lokichubs/TerraProbe/Documentation/CDR/FBD_Shaft_Design.pptx

y

z

x

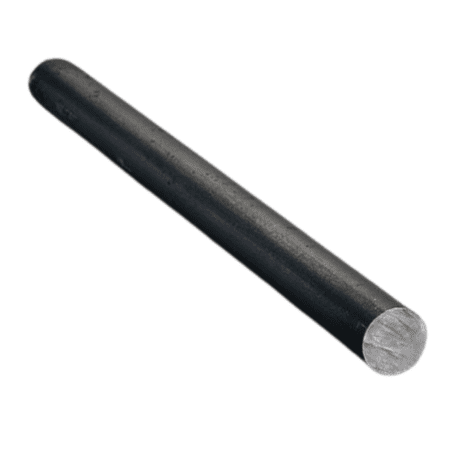
[picture p1: figure]
Plain Steel Shaft, 1 1/4 in x 3 ft - MDS

R_y

W_t

B_y

R_z

x = 0.375”

W_(tz)

B_z

x = 2.75”

3”
