lokichubs/TerraProbe/Documentation/CDR/Dashboard_Design.pptx

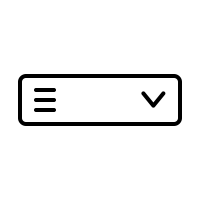
[picture p79: figure]
Dropdown Menu Icons - Free SVG & PNG Dropdown Menu Images - Noun Project

A Down2Earth (D2E)
Company

Soil-IQ Analytics Platform

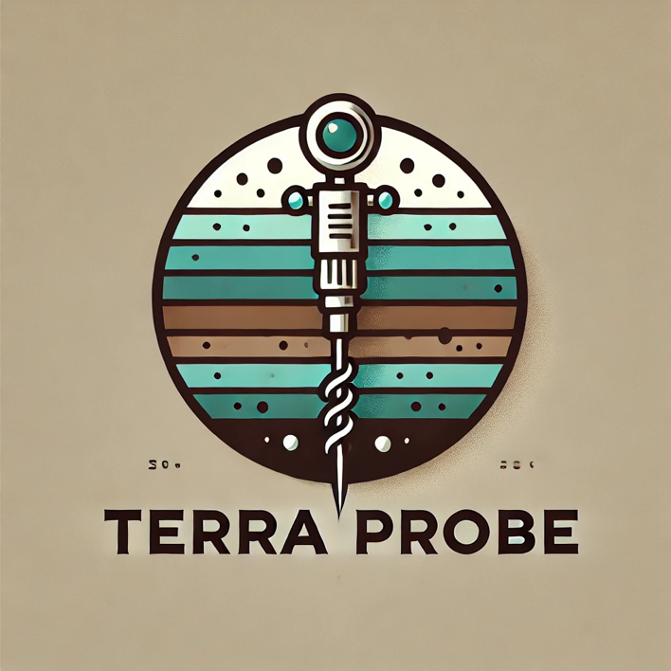
[picture p80: figure]

Soil Depth Properties at Depth of 2 inches

Read & Update Data

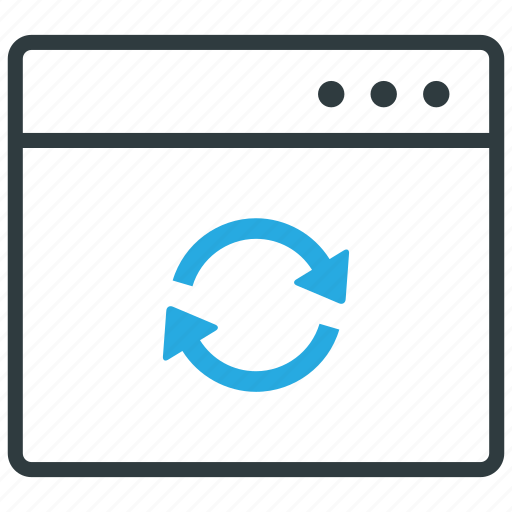
[picture p81: figure]
Browser, update, website, sync icon - Download on Iconfinder

Clear Data

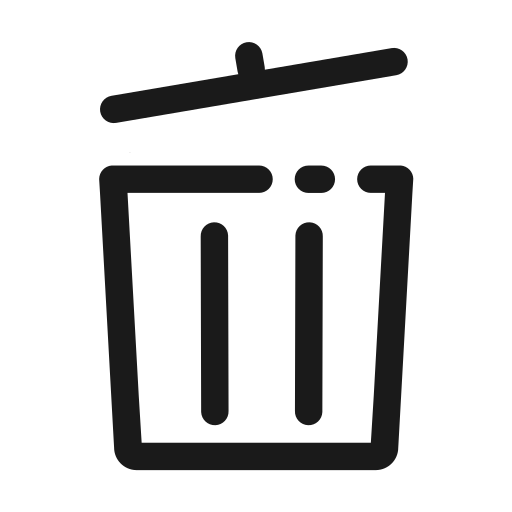
[picture p82: figure]
delete Vector Icons free download in SVG, PNG Format

Select Depth Measurements

2”

0.2

Moisture

50
mg/kg

Nitrogen

115
mg/kg

Potassium

123
mg/kg

Phosphorous

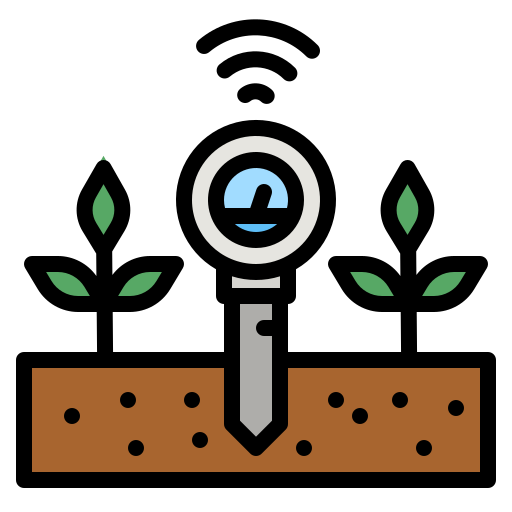
[picture p83: figure]
Soil analysis - Free farming and gardening icons
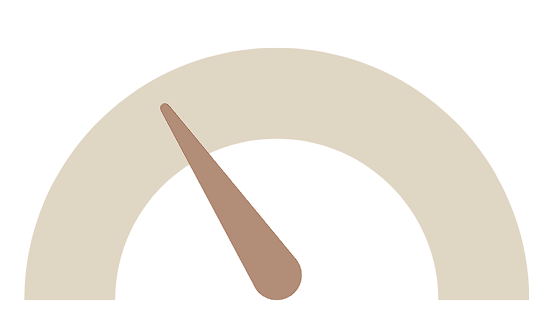
[picture p84: figure]
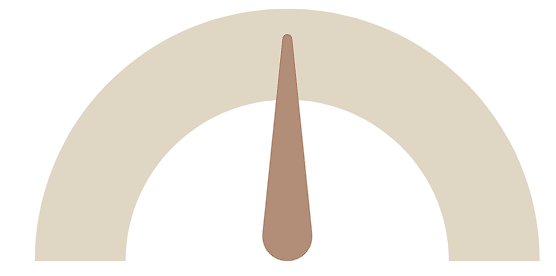
[picture p85: figure]
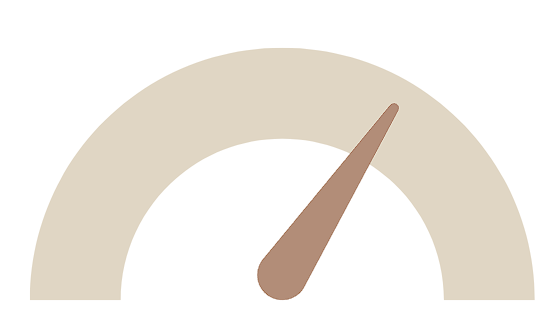
[picture p86: figure]

Select Depths to Extract

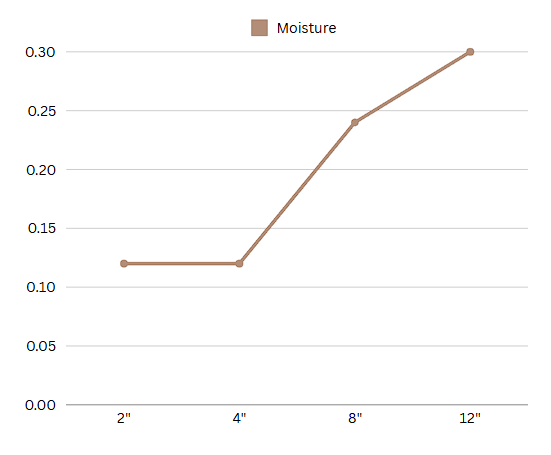
[picture p87: figure]

📈 Dual-Line Chart: Overlay moisture percentage and nitrogen concentration over time to show if excess water is leading to nutrient depletion (Potential Leaching Risk)

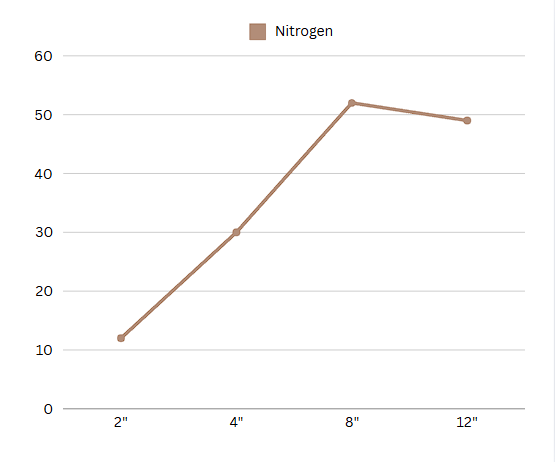
[picture p88: figure]
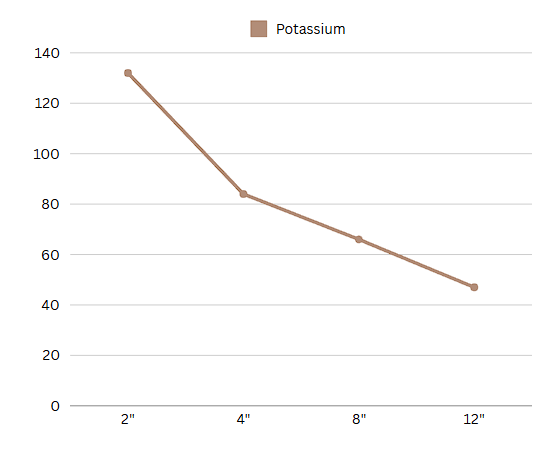
[picture p89: figure]
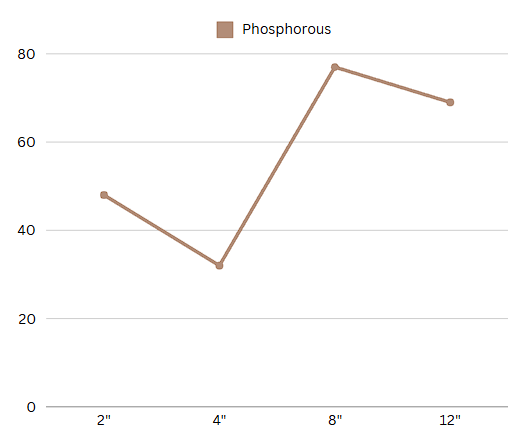
[picture p90: figure]

📊 Predictive Yield Graph: Show expected yield under current soil conditions vs. an optimized scenario with recommended nutrient adjustments.

2”

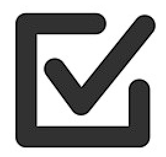
[picture p91: figure]

4”

Data-Driven Insights

🗺️ Heatmap or Contour Map: To Show different NPK and moisture levels across the field.
🎯 Zone-Based Fertilization: Highlight areas needing extra nutrients and overlay recommended fertilizer application rates.

8”

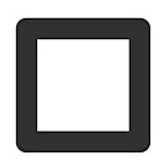
[picture p92: figure]

12”
