lokichubs/TerraProbe/Documentation/CDR/CAD Folder/Screenshot 2025-03-02 230439.png

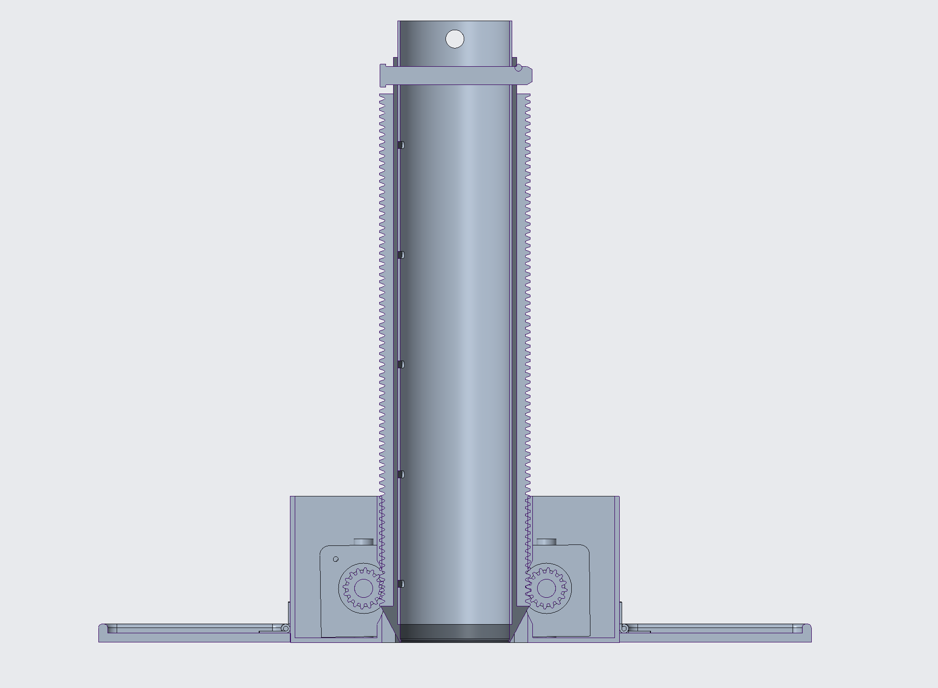
Documentation/CDR/CAD Folder/Screenshot 2025-03-02 230439.png
