lokichubs/TerraProbe/Documentation/CDR/CAD Folder/Screenshot 2025-03-06 202336.png

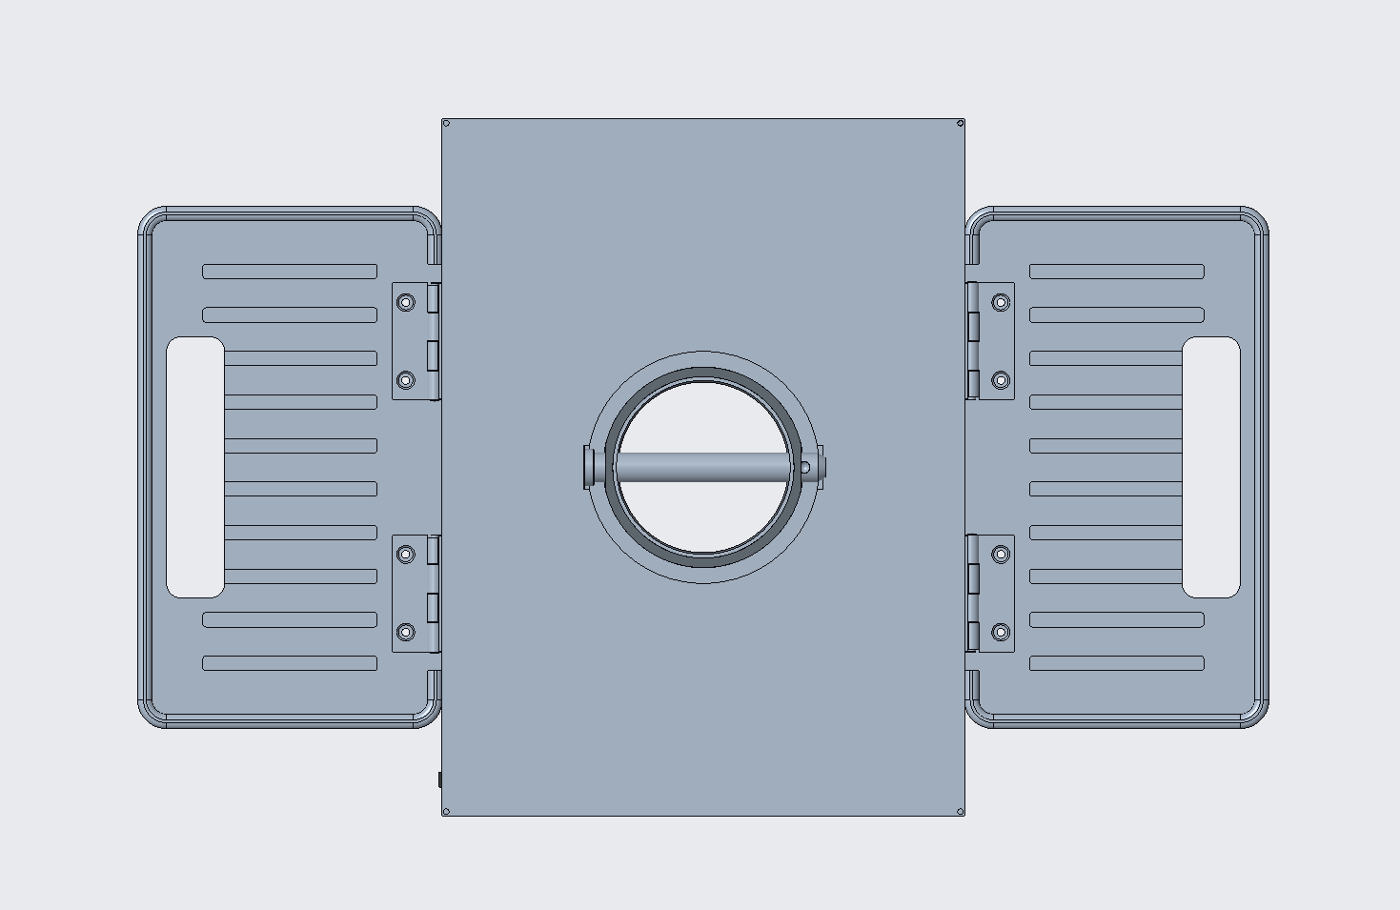
Documentation/CDR/CAD Folder/Screenshot 2025-03-06 202336.png
