lokichubs/TerraProbe/Documentation/FDR/Budget_BOM - ME463.xlsx

 | ME 463 Senior Design |  |  |  | Yellow = Ordered
Team Name: | TerraProbe | Date: | 2025-03-14
PENDING ORDERS
Item Description | How will the item be used for the project? | Vendor | Total Item Cost | Shipping Cost | Estimated Purchase date
Arduino | Main Controller Module (x 2) | ME E-shop (https://www.amazon.com/Arduino-A000066-ARDUINO-UNO-R3/dp/B008GRTSV6?s=electronics) | $0.00 | $0.00 | 2025-02-20
NPK Soil Sensor | Measure Nitrogen, Phosphorous, Potassium content (x1) | Amazon (https://www.amazon.com/Xinwoer-Precision-Nutrient-Intelligent-Fertilizer/dp/B07ZKTK8QR) | $49.52 | $0.00 | 2025-02-20
Soil Moisture Sensor | Measure moisture content of soil (x1) | Personal (https://www.amazon.com/HiLetgo-Moisture-Automatic-Watering-Arduino/dp/B01DKISKLO) | $0.00 | $0.00 | 2025-02-25
Motor Driver | Motor controller to ESP 32 module (x2) | ME E-shop (https://www.amazon.com/BOJACK-H-Bridge-Controller-Intelligent-Mega2560/dp/B0C5JCF5RS) | $0.00 | $0.00 | 2025-02-20
SD Card Module | Transfer data for SD Card Module (x2) | Amazon (https://www.amazon.com/Virtuabotix-Reader-Writer-Arduino-Microcontrollers/dp/B0089SYU9C?s=electronics) | $15.00 | $0.00 | 2025-02-20
Barrel Plug | Barrel Plug connection for battery | ME E-shop (https://www.amazon.com/Connector-Barrel-Adapter-Security-Camera/dp/B09S3S6RYC) | $0.00 | $0.00 | 2025-02-20
Transceiver | Transceiver module (x10) | Amazon (https://www.amazon.com/ANMBEST-Transceiver-Arduino-Raspberry-Industrial-Control/dp/B088Q8TD4V?s=electronics) | $9.99 | $0.00 | 2025-02-20
12V/5V Dual Battery | Battery for DAQ System (x2) | Personal (https://www.amazon.com/TalentCell-Rechargeable-3000mAh-Lithium-External/dp/B01M7Z9Z1N?s=electronics) | $0.00 | $0.00 | 2025-02-20
Button Module | 5 in 1 Module for buttons (x2) | Amazon (https://www.amazon.com/Midzooparts-Keyboard-Simulate-arduino-Expansion/dp/B09P46G71T?s=industrial) | $13.82 | $0.00 | 2025-03-14
Limit Switches | Control Module for limmiting vertical motion | Amazon (https://www.amazon.com/HiLetgo-KW12-3-Roller-Switch-Normally/dp/B07X142VGC) | $5.99 | - | 2025-03-14
High Torque Motors | For pinion gears mechanism 12V, 35W, 30RPM (x2) | Amazon (https://www.amazon.com/DC12V-Motor-Adjustable-Torque-600rpm/dp/B07GBRS7NL) | $95.06 | $0.00 | 2025-02-20
OLED Display Module | Real time data shown to user (x1) | Amazon (https://www.amazon.com/Hosyond-Display-Self-Luminous-Compatible-Raspberry/dp/B09C5K91H7) | $14.98 | $0.00 | 2025-02-20
Pinion Gear | Part #1 for drill mechanism (x2) | McMasterCarr (https://www.mcmaster.com/5172T63/) | $90.42 | $0.00 | 2025-02-26
Rack Gear | Part #2 for drill mechanism (x1) | McMasterCarr (https://www.mcmaster.com/5174T12/) | $70.11 | $0.00 | 2025-02-26
Outer Tubing Round | Part No.T2312250 ( 2ft x 3-1/2" OD x .250" wall x 3.00" ID A513-T5 DOM Round Steel Tube) | Metals Depot (https://www.metalsdepot.com/steel-products/steel-round-tube-dom?product=1395) | $109.40 | $14.06 | 2025-03-14
Inner Tubing Round | Stainless Steel 304, A=3, B=0.065, Dimension=17in, (x1) | Metal Supermarkets (https://www.metalsupermarkets.com/product/stainless-steel-round-tube-304/) | $45.44 | $0.00
Sheet Metal | Thickness: .25", 12X12" | Amazon (https://www.amazon.com/Steel-Rolled-Welding-Cutting-Baking/dp/B0BS9DQDXZ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) | $35.99 | $0.00 | 2025-04-01
Key | For gear design (x1 Pack) | McMasterCarr (https://www.mcmaster.com/98870A090/) | $15.16 | $0.00 | 2025-02-26
Bearings | (x2) | McMasterCarr (https://www.mcmaster.com/60355K291/) | $16.08 | $0.00 | 2025-02-26
Heavy Duty Snap Rings | ID 3" | McMasterCarr (https://www.mcmaster.com/catalog/131/3768/91985A341) | $14.07 | - | 2025-04-08
Screw #3 | M4, 0.7mm thread pitch, 8mm length | McMasterCarr (https://www.mcmaster.com/90258A212/) | $9.10 |  | 2025-04-08
UHMW Plastic | 12"x24"x0.25" (x1) | McMasterCarr (https://www.mcmaster.com/8752K213/) | $26.37 | $0.00
90 degree USB adapter | For battery to arduino connection (x1) | Amazon (https://www.amazon.com/AreMe-Adapter-Converter-Extender-Charger/dp/B0C7V37X25) | $9.99
Pins | (x1 Pack) | McMasterCarr (https://www.mcmaster.com/90156A584/) | $9.78 | $0.00
Hinges | (x4) | McMasterCarr (https://www.mcmaster.com/1586A23/) | $53.40 | $0.00
Brush | Autonomous cleaning (x1) | Amazon (https://www.amazon.com/FUNOMOCYA-Circuit-Cleaning-Bristle-Plastic/dp/B0DL4V5J4C?s=apparel) | $7.39
Screw #1 | For foot pedal (x1Pack) | McMasterCarr (https://www.mcmaster.com/91771A191/) | $8.35 | $0.00
Screw #2 | Screws for lids (x1 Pack) | McMasterCarr (https://www.mcmaster.com/91772A096/) | $7.33 | $0.00
Shaft | 0.5" Diameter, 1ft length | McMasterCarr (https://www.mcmaster.com/6818T53/) | $16.38 | $0.00 | 2025-02-26
Plexigalss | 1/8" thick plexiglass (x2) | Amazon (https://www.amazon.com/Pieces-Clear-Acrylic-Sheet-Plexiglass/dp/B0CQYQLT31) | $15.99 | $0.00 | 2025-02-20
Vinyl Cap | Cap to close inner payload (x2) | United States Plastic Corp (https://www.usplastic.com/catalog/item.aspx?itemid=136912&v1=&v7=&gad_source=1) | $3.48 | $0.00
 |  | TOTAL | $765.11 | $14.06 | $779.17
COMPLETED ORDERS
Item Description | How will the item be used for the project? | Vendor | Item Cost | Shipping Cost | Purchase date
 |  | TOTAL | $0.00 | $0.00 | $0.00
 |  | GRAND TOTAL | $765.11 | $14.06 | $779.17
