lokichubs/TerraProbe/Documentation/PDR/Budget_BOM - ME463.xlsx

Sheet: Budget
 |  | ME 463 Senior Design
 | Team Name: | TerraProbe | Date: | 2025-02-11
 | PENDING ORDERS
 | Item Description | How will the item be used for the project? | Vendor | Item Cost | Shipping Cost | Estimated Purchase date
 | ESP 32 Module/Arduino Uno | Main Controller Module (x 3) | Amazon (https://www.amazon.com/ESP-WROOM-32-Development-Microcontroller-Integrated-Compatible/dp/B08D5ZD528) | $15.99 | $0.00 | 2025-02-15
 | NPK Soil Sensor | Measure Nitrogen, Phosphorous, Potassium content (x2) | Amazon (https://www.amazon.com/Xinwoer-Precision-Nutrient-Intelligent-Fertilizer/dp/B07ZKTK8QR) | $47.12 | $0.00 | 2025-02-15
 | Soil Moisture Sensor | Measure moisture content of soil (x5) | Amazon (https://www.amazon.com/Stemedu-Capacitive-Corrosion-Resistant-Electronic/dp/B0BTHL6M19) | $8.68 | $0.00 | 2025-02-15
A | Soil Tempreature | Soil Tempreature content (x3) | Amazon (https://www.amazon.com/WWZMDiB-Temperature-High-Accuracy-Waterproof-Experiments/dp/B0C8J77NJR) | $9.99 | $0.00 | 2025-02-15
 | 24V/5V Battery | Battery for Motors and ESP 32 (x1) | Amazon (https://www.amazon.com/TalentCell-PB240A1-Rechargeable-22400mAh-82-88Wh/dp/B078T7M9HZ) | $61.99 | $0.00 | 2025-02-15
 | Motor Driver | Motor controller to ESP 32 module (x2) | Amazon (https://www.amazon.com/DROK-Controller-Regulator-Industrial-Optocoupler/dp/B06XGD5SCB) | $31.98 | $0.00 | 2025-02-15
 | 12V/5V Dual Battery | Battery for DAQ System (x1) | Amazon (https://www.amazon.com/TalentCell-Rechargeable-3000mAh-Lithium-External/dp/B01M7Z9Z1N) | $23.99 | $0.00 | 2025-02-15
 | High Torque Motors | For pinion gears mechanism (x2) | Walmart (https://www.walmart.com/ip/GELUOXI-DC-24V-Electric-Gear-Motor-45W-220RPM-30NM-High-Torque-Speed-Reduction-Motor/5426739694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) | $98.00 | $0.00 | 2025-02-15
 | Electrical Switches | To turn mechanisms on and off and other controls (x1) | Amazon (https://www.amazon.com/s?k=switches+arduino&crid=2QEP1RYWIB5GT&sprefix=switches+arduino%2Caps%2C217) | $7.99 | $0.00 | 2025-02-15
 | OLED Display Module | Real time data shown to user (x1) | Amazon (https://www.amazon.com/Hosyond-Display-Self-Luminous-Compatible-Raspberry/dp/B09C5K91H7) | $14.98 | $0.00 | 2025-02-15
 | Wires | Electrical Cables (x1) | Amazon (https://www.amazon.com/Stranded-Electrical-Flexible-Silicone-Electric/dp/B09TK83NVP) | $14.99 | $0.00 | 2025-02-15
 | Soldering Iron | For all electrical circuit making (x1) | Amazon (https://www.amazon.com/Liouhoum-Auto-Sleep-Adjustable-Temperature-Thermostatic/dp/B08PZBPXLZ) | $9.99 | $0.00 | 2025-02-15
 | Heat Shrink wraps for wires | Connecting wires together (x1) | Amazon (https://www.amazon.com/560PCS-Heat-Shrink-Tubing-Eventronic/dp/B072PCQ2LW) | $5.99 | $0.00 | 2025-02-15
 | Pinion Gear | Part #1 for drill mechanism (x2) | McMasterCarr | $71.87 | $0.00 | 2025-02-15
 | Rack Gear | Part #2 for drill mechanism (x2) | McMasterCarr | $101.87 | $0.00 | 2025-02-15
 | Square Tubing | Part #3 Soil Payload for mechaism (x1) | McMasterCarr | $110.25 | $0.00 | 2025-02-15
 | Plexigalss | 1/8" thick plexiglass (x2) | Amazon (https://www.amazon.com/Pieces-Clear-Acrylic-Sheet-Plexiglass/dp/B0CQYS1RN6) | $14.99 | $0.00 | 2025-02-15
 | Machining Cost | If additional metals or machining is required | Fabrication Shops | $0.00 | $0.00 | NA
 | 3D Priniting | No cost as Purdue labs will be used | Rapid Prototyping Lab | $0.00 | $0.00 | NA
 |  |  | TOTAL | $650.66 | $0.00 | $650.66
 | COMPLETED ORDERS
 | Item Description | How will the item be used for the project? | Vendor | Item Cost | Shipping Cost | Purchase date
 | 6160 Aluminum bar stock (2"x3"x24") | It will be machined to form the main structure of the chassis | www.onlinemetals.com | $0.00 | $18.51 | 2021-02-27
 |  |  | TOTAL | $0.00 | $18.51 | $18.51
 |  |  | GRAND TOTAL | $650.66 | $18.51 | $669.17

Sheet: Sheet2
Item Description | How will the item be used for the project? | Vendor | Item Cost
ESP 32 Module/Arduino Uno | Main Controller Module (x 3) | Amazon (https://www.amazon.com/ESP-WROOM-32-Development-Microcontroller-Integrated-Compatible/dp/B08D5ZD528) | $15.99
NPK Soil Sensor | Measure Nitrogen, Phosphorous, Potassium content (x2) | Amazon (https://www.amazon.com/Xinwoer-Precision-Nutrient-Intelligent-Fertilizer/dp/B07ZKTK8QR) | $47.12
Soil Moisture Sensor | Measure moisture content of soil (x5) | Amazon (https://www.amazon.com/Stemedu-Capacitive-Corrosion-Resistant-Electronic/dp/B0BTHL6M19) | $8.68
Soil Tempreature | Soil Tempreature content (x3) | Amazon (https://www.amazon.com/WWZMDiB-Temperature-High-Accuracy-Waterproof-Experiments/dp/B0C8J77NJR) | $9.99
24V/5V Battery | Battery for Motors and ESP 32 (x1) | Amazon (https://www.amazon.com/TalentCell-PB240A1-Rechargeable-22400mAh-82-88Wh/dp/B078T7M9HZ) | $61.99
Motor Driver | Motor controller to ESP 32 module (x2) | Amazon (https://www.amazon.com/DROK-Controller-Regulator-Industrial-Optocoupler/dp/B06XGD5SCB) | $31.98
12V/5V Dual Battery | Battery for DAQ System (x1) | Amazon (https://www.amazon.com/TalentCell-Rechargeable-3000mAh-Lithium-External/dp/B01M7Z9Z1N) | $23.99
High Torque Motors | For pinion gears mechanism (x2) | Walmart (https://www.walmart.com/ip/GELUOXI-DC-24V-Electric-Gear-Motor-45W-220RPM-30NM-High-Torque-Speed-Reduction-Motor/5426739694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) | $98.00
Electrical Switches | To turn mechanisms on and off and other controls (x1) | Amazon (https://www.amazon.com/MTS-101-Position-Miniature-Toggle-Switch/dp/B0799LBFNY) | $7.99
OLED Display Module | Real time data shown to user (x1) | Amazon (https://www.amazon.com/Hosyond-Display-Self-Luminous-Compatible-Raspberry/dp/B09C5K91H7) | $14.98
Wires | Electrical Cables (x1) | Amazon (https://www.amazon.com/Stranded-Electrical-Flexible-Silicone-Electric/dp/B09TK83NVP) | $14.99
Soldering Iron | For all electrical circuit making (x1) | Amazon (https://www.amazon.com/Liouhoum-Auto-Sleep-Adjustable-Temperature-Thermostatic/dp/B08PZBPXLZ) | $9.99
Heat Shrink wraps for wires | Connecting wires together (x1) | Amazon (https://www.amazon.com/560PCS-Heat-Shrink-Tubing-Eventronic/dp/B072PCQ2LW) | $5.99
Pinion Gear | Part #1 for drill mechanism (x2) | McMasterCarr | $71.87
Rack Gear | Part #2 for drill mechanism (x2) | McMasterCarr | $101.87
Square Tubing | Part #3 Soil Payload for mechaism (x1) | McMasterCarr | $110.25
Plexigalss | 1/8" thick plexiglass (x2) | Amazon (https://www.amazon.com/Pieces-Clear-Acrylic-Sheet-Plexiglass/dp/B0CQYS1RN6) | $14.99
Machining Cost | If additional metals or machining is required | Fabrication Shops | $0.00
3D Priniting | No cost as Purdue labs will be used | Rapid Prototyping Lab | $0.00
 |  | TOTAL | $650.66
