lokichubs/TerraProbe/Documentation/FDR/FMEA_FDR.xlsx

Sheet: FMEA
ME 463 Senior Design
Project Name: TerraProbe, a Down2Earth (D2E) Company
Line No. | Item / Function | Potential Failure Mode | Potential Effect(s) of Failure | SEV | Potential Cause(s) / Mechanism(s) of Failure | OCC | Current Controls | DET | RPN | Mitigation Action (s) | by Who | by When | New SEV | New OCC | New DET | New RPN
1 | Motor System | Overheating of the Motors | Motor System Failure, Reduced Lifespan | 8 | Excessive Torque Demand, Prolonged Operation | 6 | Thermal sensors, ventilation for heat reduction | 5 | 240 | Upgrade motor specs, add heat sinks and ventilation, shut down after 30 mins of use | Avie (Electronics) | 2025-03-20 | 6 | 3 | 3 | 54
2 | Gear Mechanism | Excessive Wear and Tear, Scraping of Teeth | Reduced Efficiency, Failure | 7 | High Loads, No or poor lubrication | 6 | Routine Maintenance and Lubrication, Gear Theoretical Analysis | 4 | 168 | Use Hardened Steel Gears (High Strength) | Lokesh (Analysis & Gear System) | 2025-03-14 | 5 | 3 | 3 | 45
3 | Inner & Outer Payload Alignment | Tolerancing between payloads causes jamming or too loose | Jamming, Uneven Penetration, Not Tight Fit - Inner Payload Falls Out | 7 | Improper assembly, excessive force, tolerancing, temperature/water effects | 5 | Assembly Tolerancing, Material Selection (High-Yield) | 5 | 175 | Improve assembly process, provide small slit/insert for easy inner tube access | Chris (CAD & GD&T) | 2025-03-14 | 5 | 3 | 3 | 45
4 | Power System | Battery Depletion / Battery Life | Device Shutdown | 9 | High enery consumption, faulty charging (indefinite charging), low usage | 6 | Batter health/status monitor, Power Management (Energy Conservation) | 5 | 270 | Optimize power use, add backup battery | Avie (Electronics) | 2025-03-07 | 6 | 3 | 3 | 54
5 | Sensor Module | Sensor Failure (Moisture or NPK) | No data collected, no analytics | 9 | Wiring failure, shock damage, sensor tip broken | 5 | Shock-absorbing mount, compact casing & wiring for sensors | 4 | 180 | Soldering of wires, easy maintenance path | Sankaran (Electronics & Probe Assembly) | 2025-03-20 | 8 | 3 | 3 | 72
6 | Housing & Seals | Soil Water Ingress | Electronics damage, device malfunction | 9 | Poor sealing, extreme weather/soil conditions | 5 | IP-rated casing, waterproof seals | 4 | 180 | Improve sealing, keep motor and electronics away from soil and above ground | Lokesh (Assembly Manufacturing) | 2025-03-14 | 7 | 3 | 3 | 63
7 | Display Interface | Screen Malfunction | User unable to interact or see messages on the screen | 7 | Electrical failure, impact damage | 5 | Reinforced screen, diagnostic alerts, maintenance and repair | 4 | 140 | Keep screen away from soil and not exposed to water | Electronics/UI (Avie & Sankaran) | 2025-03-20 | 5 | 3 | 3 | 45
8 | SD Card Malfunction | Data Processing/Reading Errors | Incorrect or No Analysis Results | 8 | Bug in code, Data Acqusition System Malfunction, SD Card Corrupted | 5 | Executable file with automated user notifications | 4 | 160 | Improve & add error handling notifications, push software updates automatically | Sankaran (Software) | 2025-03-27 | 4 | 3 | 3 | 36
9 | Mechanical Couplings | Loose connnections | Component detachment, Assembly Breaking | 8 | Vibration, poor assembly | 6 | Secure fastening, thread-locking compounds | 5 | 240 | Reinforce fasteners, vibration-resistant | Chris (CAD & Design) | 2025-03-27 | 7 | 3 | 3 | 63
10 | Data Transmission | Signal Loss, No or Incorrect Data Collected | Incomplete, delayed data | 8 | Interference, Weak Signal, SD Card Broken, Arduino Code Corrupted | 6 | MicroSD card, Arduino Uno Cable Management | 5 | 240 | Switch do SD Card to avoid loss or breaking of card, use Arduino Mega for more pins | Avie & Sankaran (Electronics & Test Probe) | 2025-03-20 | 5 | 3 | 3 | 45
11 | Motor Driver System | Inadequate Torque Output (Power Wattage Issue) | Cannot reach target 12" depth; soil sample failure | 9 | Motor Torque is insufficient under drier soil conditions | 8 | IR Sensor Testing and run motors on max PWM | 2 | 144 | Seeking more powerful motors with higher speed and constant power (50 RPM) | Avie & Sankaran (Electronics & Test Probe) |  |  |  |  | 0
12 | Power Delivery System | Battery Voltage drops under load | Motor stalls, RPM drops, slower sampling | 8 | High internal resistance, Low Battery Capacity | 5 | Fully Charged Battery to maximize power | 8 | 320 | Upgrade to 24V lithium battery and add a voltage regulator | Lokesh (Battery Management) |  |  |  |  | 0
13 | Foot Pedal System | Screws slipping from the foot pedals during testing | Loss of user-applied force; safety concern | 9 | UHMW plastic fatigue under load; Loose screws | 6 | Threaded screws | 3 | 162 | Added Bolts | Lokesh (Assembly Manufacturing) |  | 9 | 2 | 1 | 18
14 | Gear/Rack Mechanism | Angled or not full mesh between gear teeth and rack | Halting motors, causing machine to stop. Shell gets stuck in between gear-motor assembly | 8 | Incorrect Assembly or Excessive Vibrations | 5 | Loosened Bearings Mount, Motor Mounts to provide freedom of movement | 5 | 200 | Removed Shell guide for reduced inteference and freedom of movement | Chris (Assembly & CAD) |  | 6 | 5 | 3 | 90
15 |  |  |  |  |  |  |  |  | 0 |  |  |  |  |  |  | 0
16 |  |  |  |  |  |  |  |  | 0 |  |  |  |  |  |  | 0
17 |  |  |  |  |  |  |  |  | 0 |  |  |  |  |  |  | 0
18 |  |  |  |  |  |  |  |  | 0 |  |  |  |  |  |  | 0
19 |  |  |  |  |  |  |  |  | 0 |  |  |  |  |  |  | 0
20 |  |  |  |  |  |  |  |  | 0 |  |  |  |  |  |  | 0

Sheet: Ranking Criteria
DESIGN FAILURE MODES AND EFFECTS ANALYSIS
RANKING CRITERIA
SEVERITY
Ranking | Description
1 | No Effect
2 | Very Minor
3 | Minor
4 | Very Low
5 | Low
6 | Moderate
7 | High
8 | Very High
9 | Hazardous - With Warning
10 | Hazardous - Without Warning
OCCURRENCE
Ranking | Description
1 | Never
2 | Remote
3 | Minor - Very Rare
4 | Very Low - Rare
5 | Low- Sporadic
6 | Moderate - Infrequent
7 | Moderate - Occasional
8 | High - Repeated
9 | High - Frequent
10 | Very High - Inevitable
DETECTION
Ranking | Description
1 | Design/Process controls will reliably detect failure mode.
2 | Very High
3 | High
4 | Moderately High
5 | Moderate - Average
6 | Moderate - Poor
7 | Low
8 | Remote
9 | Very Remote
10 | Impossible
