lokichubs/TerraProbe/Documentation/FDR/Risk_Register_FDR.xlsx

Sheet: 1. Scoring Matrix
For ME463, this scoring matrix has been defined for you. Reference it for accurate & consistent scoring of your risks, but do not modify it.
 |  | IMPACT
Score | PROBABILITY | Schedule | Budget | Product Requirements
HIGH | >25% | > 7 days | > $150 | Key requirements are significantly compromised.
MEDIUM | 11-25% | 4 - 7 days | $61 - $150 | Primary (key) requirements are partially compromised and/or secondary requirements are significantly compromised.
LOW | <10% | < 3 days | < $60 | Secondary requirements are partially compromised, but primary (key) requirements are not.

Sheet: 2. Risk Register
1. IDENTIFICATION |  |  |  |  |  | 2. CURRENT ASSESSMENT |  |  | 3. TREATMENT |  | 4. RESIDUAL ASSESSMENT |  |  | 5. REVIEW, CONTROL, COMMUNICATE
ID | RAISED BY | DATE RAISED | CAUSE (IF…) | EFFECT (THEN…) | RISK OWNER | P | I | Current Risk Score | STRATEGY | TREATMENT DESCRIPTION | P | I | Residual Risk Score | Commentary | Last Updated
14 |  |  |  |  |  |  |  | #N/A |  |  |  |  | #N/A
15 |  |  |  |  |  |  |  | #N/A |  |  |  |  | #N/A
16 |  |  |  |  |  |  |  | #N/A |  |  |  |  | #N/A
17 |  |  |  |  |  |  |  | #N/A |  |  |  |  | #N/A
18 |  |  |  |  |  |  |  | #N/A |  |  |  |  | #N/A
19 |  |  |  |  |  |  |  | #N/A |  |  |  |  | #N/A
20 |  |  |  |  |  |  |  | #N/A |  |  |  |  | #N/A
21 |  |  |  |  |  |  |  | #N/A |  |  |  |  | #N/A
22 |  |  |  |  |  |  |  | #N/A |  |  |  |  | #N/A
23 |  |  |  |  |  |  |  | #N/A |  |  |  |  | #N/A
24 |  |  |  |  |  |  |  | #N/A |  |  |  |  | #N/A
25 |  |  |  |  |  |  |  | #N/A |  |  |  |  | #N/A
26 |  |  |  |  |  |  |  | #N/A |  |  |  |  | #N/A
27 |  |  |  |  |  |  |  | #N/A |  |  |  |  | #N/A
28 |  |  |  |  |  |  |  | #N/A |  |  |  |  | #N/A
29 |  |  |  |  |  |  |  | #N/A |  |  |  |  | #N/A
30 |  |  |  |  |  |  |  | #N/A |  |  |  |  | #N/A
31 |  |  |  |  |  |  |  | #N/A |  |  |  |  | #N/A
32 |  |  |  |  |  |  |  | #N/A |  |  |  |  | #N/A
33 |  |  |  |  |  |  |  | #N/A |  |  |  |  | #N/A
34 |  |  |  |  |  |  |  | #N/A |  |  |  |  | #N/A
35 |  |  |  |  |  |  |  | #N/A |  |  |  |  | #N/A
36 |  |  |  |  |  |  |  | #N/A |  |  |  |  | #N/A
37 |  |  |  |  |  |  |  | #N/A |  |  |  |  | #N/A
38 |  |  |  |  |  |  |  | #N/A |  |  |  |  | #N/A
39 |  |  |  |  |  |  |  | #N/A |  |  |  |  | #N/A
40 |  |  |  |  |  |  |  | #N/A |  |  |  |  | #N/A
41 |  |  |  |  |  |  |  | #N/A |  |  |  |  | #N/A
42 |  |  |  |  |  |  |  | #N/A |  |  |  |  | #N/A
43 |  |  |  |  |  |  |  | #N/A |  |  |  |  | #N/A
44 |  |  |  |  |  |  |  | #N/A |  |  |  |  | #N/A
45 |  |  |  |  |  |  |  | #N/A |  |  |  |  | #N/A
46 |  |  |  |  |  |  |  | #N/A |  |  |  |  | #N/A
47 |  |  |  |  |  |  |  | #N/A |  |  |  |  | #N/A
48 |  |  |  |  |  |  |  | #N/A |  |  |  |  | #N/A
49 |  |  |  |  |  |  |  | #N/A |  |  |  |  | #N/A
50 |  |  |  |  |  |  |  | #N/A |  |  |  |  | #N/A
 | The originator of the risk | When the risk was first identified | If uncertain event occurs due to (or because of) specified root cause(s). Tip: ask "why, why, why…" to drill down to root cause | then the ultimate impact to our objectives are. Tip: ask "so what, so what, …" | Single named owner | Probability of the event occurring | 'Worst' impact | Calculated risk score | Select overall approach to treatment (Mitigate or Accept) | Summary of the treatment responses (actions, controls, fallbacks) that treat the risk. | Probability of the event occurring | 'Worst' impact | Calculated risk score | Any additional notes, comments or actions | Enter the last review or update date for the risk
1 | Jacob McKenrick | 2025-02-02 | Machine tries to extract too much soil which adds unexpected weight to the system | Overloading lifting system |  | M | H | 15 | Mitigate | Factor of safety of 3.0 used in design for the rack and pinion system | L | H | 11 |  | 2025-03-06
2 | Jacob McKenrick | 2025-02-02 | Gear is improperly lubricated leading to rubbing and wear | Rack and pinion failure |  | M | H | 15 | Mitigate | Provide guide on how often, and how to lubricate gears in rack and pinion system | L | H | 11 |  | 2025-03-06
10 | Jacob McKenrick | 2025-02-02 | Pinch points in rack and pinion system during extraction which could jam fingers | Operator Injury |  | M | H | 15 | Mitigate | Added limit switches as an Estop for rack and pinion system. Added safety covers over pinch points | L | M | 6 |  | 2025-03-06
3 | Jacob McKenrick | 2025-02-02 | Soil gets lodged between teeth in the rack and pinion system | Rack and pinion jamming |  | H | M | 14 | Mitigate | Cover rack and pinion as much as possible with machine frame to prevent liklehood of soil jamming | L | M | 6 |  | 2025-03-06
4 | Jacob McKenrick | 2025-02-02 | Vibrations jeopardize structural integrity due to prolonged use over a long period of time | Machine frame could damage or break |  | L | H | 11 | Accept | Could use stronger material resistant to vibrations | L | H | 11 |  | 2025-03-06
5 | Jacob McKenrick | 2025-02-02 | Wear on bearings due to use over time | Bearing failure |  | M | M | 10 | Mitigate | Design bearings for a large factor of safety | L | M | 6 |  | 2025-03-06
7 | Jacob McKenrick | 2025-02-02 | Short circuits or loose connections leading to open circuits | Electrical Malfunction |  | M | M | 10 | Mitigate | Ensure connections are strong and stable. Prevent wires from being exposed. | L | M | 6 |  | 2025-03-06
6 | Jacob McKenrick | 2025-02-02 | Dirt, moisture, or calibration issues leading to disconnected wires or jammed sensors | Sensor malfunction |  | H | L | 9 | Accept | Operator can always test samples several times to reduce error | H | L | 9 |  | 2025-03-06
8 | Jacob McKenrick | 2025-02-02 | Electomagnetic interference could influence data collection | Electrical Malfunction |  | L | M | 6 | Accept | Operator can always test samples several times to reduce error | L | M | 6 |  | 2025-03-06
11 | Jacob McKenrick | 2025-02-02 | Instability of machine in soft soil which could lead to sinking into the dirt | Machine could fall over |  | L | M | 6 | Mitigate | Foot pedals added for operator to stand on to add stability to design | L | M | 6 |  | 2025-03-06
12 | Jacob McKenrick | 2025-02-02 | Expelling of machine lubricant due to inner or outer payload | Soil Contamination |  | L | M | 6 | Accept | Look for more environmentally safe lubricant, use proper amount of lubricant | L | M | 6 |  | 2025-03-06
13 | Jacob McKenrick | 2025-02-02 | Machine is loud | Noise Pollution |  | M | L | 5 | Accept | Look into noise reduction or lubricant | M | L | 5 |  | 2025-03-06
9 | Jacob McKenrick | 2025-02-02 | Software errors | Incorrect Data Collection |  | L | L | 1 | Accept | Double check software during testing | L | L | 1 |  | 2025-03-06
