lokichubs/TerraProbe/Documentation/FDR/Operation_Sheets.xlsx

Sheet: Outer Shell
Step | Operation | Description | Equipment | Notes
1 | Raw Stock | 2ft length 3.5 Ø OD- Trim down to 15.875 in | Band Saw
2 | Face Ends | Face cut end | Lathe | Make cut face smooth
3 | Tool Down | Tool down to 3.213 Ø OD | Lathe
4 | Internal Ring Groove | Depth of 0.03 for internal snap ring | Lathe | Outlined in Drawing
5 | End Mill | 0.044 Down along entire length | Mill | This creates a cut width of 0.75
6 | Center Drill | #0 Center Drill 0.03 Deep | Mill
7 | Drill | Ø 0.25, Through next | Mill | Repeat steps 5,6,7 after flipping 180 degrees
8 | Debur | Remove Facing Bur | Pedestal Grinder | >100 Grit
9 | Hand Debur | Remove all sharp edges | Hand tool

Sheet: Sheet Metal Base
Step | Operation | Description | Equipment | Notes
1 | Raw Stock | 0.125" x 12" x 9" Sheet Metal Stainless Steel | Bandsaw | 200 FPM
2 | Laser Cut | Ø 3.214" hole and side rack cutouts | Laser Cut | Verify Cut Dimensions as per drawing to accomodate rack and shell
3 | Center Drill | Mark 8 hole locations as per drawing specifications | Lathe (Center Drill) | Verify Hole Locations in the drawing
4 | Drill | Drill 8 Holes, Drill (2) holes using a #29 drill (Ø 0.136") to 0.410" depth. | Lathe | Use center drill first to guide
5 | Tap | Tap (8) holes for 8-32 UNC - 2B threads to 0.330" depth. | Lathe
6 | Hand Debur | Debur all sharp edges | Hand Tool
7
8
9

Sheet: Payload
Step | Operation | Description | Equipment | Notes
1 | Raw Stock | Cylindrical Tube 17 in long | Band Saw | Trim down to 16.5 inches long
2 | Center Drill | #0 Center Drill 0.03 Deep | Mill
3 | Drill | 0.25 Ø ,To next (for both holes | Mill | Steps 3 and 4 will be repeated on the other side after flip 180
4 | End Mill | 0.35 Ø end mill, 1.15 wide (centered), 3 1/3 inch between each slit,To next | Mill | Do for all 4 slits ONLY ON ONE SIDE
5 | Debur | Remove Facing Bur | Pedestal Grinder | >100 Grit
6 | Hand Debur | Remove all sharp edges | Hand tool

Sheet: Pinion Keyway
Step | Operation | Description | Equipment | Notes
1 | Part | Gear Provided (x2)
2 | Machine Keyway | Square mill , 0.25 deep, 1/16 tall, 1/8 across | Mill | Ensure to use triangle mill end for square finish

Sheet: Racks
Step | Operation | Description | Equipment | Notes
1 | Raw Stock | Rack Gear of 4 ft | Band saw | Cut out two pieces of 14 inches
2 | Trimming | Reduce Rack Gear Height by 3/8 inches | Mill | use square mill
3 | Taper | Taper at one end at 25 degrees from horizontal | Lathe
4 | Debur | Remove Facing Bur | Pedestal Grinder | >100 Grit
5 | Hand Debur | Remove all sharp edges | Hand tool
 | Shave Height Down to desired thickness across whole length
 | Mill

Sheet: Collar
Step | Operation | Description | Equipment | Notes
1 | Raw Stock | Stainless Steel Sheet Metal, 0.25 Thick | Laser Cut | .DXF File will be provided
2 | Debur | Remove Facing Bur | Pedestal Grinder | >100 Grit
3 | Hand Debur | Remove all sharp edges | Hand tool

Sheet: Long Side Walls (D)
Step | Operation | Description | Equipment | Notes
1 | Raw Stock | Start with 12" x 24" x 0.25" UHMW plastic sheet | -
2 | Mark Dimensions | Measure and mark the cut lines for 12" x 2.5" on the sheet. | CNC Machine | Use the CNC for marking
3 | CNC Cut | Use the CNC to trim the rough cut to exact 12" x 2.5" x 0.25" dimensions. | CNC Machine
4 | Center Drill | Mark the 4 hole locations as per drawing specifications | Lathe (Center Drill) | Verify Hole Locations in the drawing
5 | Drill | Drill 4 Holes, Drill (2) holes using a #47 drill (Ø 0.079") to 0.5" depth. | Lathe | Use center drill first to guide
6 | End Mill Cut | Use a 1/8" end mill to cut a 2.1" wide slit (refer to drawing) on the surface | End Mill | S = 60, F= Hand (locations in Drawing)
7 | Tap | Tap (8) holes for 3-48 UNC - 2B threads | Lathe
8 | Hand Debur | Remove sharp edges | Hand Tool
9

Sheet: Short Non-Battery Side Wall (D)
Step | Operation | Description | Equipment | Notes
1 | Raw Stock | Start with 12" x 24" x 0.25" UHMW plastic sheet | -
2 | Mark Dimensions | Measure and mark the cut lines for 9" x 2.5" on the sheet. | CNC Machine | Use the CNC for marking
3 | CNC Cut | Use the CNC to trim the rough cut to exact 9" x 2.5" x 0.25" dimensions. | CNC Machine
4 | Center Drill | Mark the 4 hole locations as per drawing specifications | Lathe (Center Drill) | Verify Hole Locations in the drawing
5 | Drill | Drill 4 Holes, Drill (2) holes using a #47 drill (Ø 0.079") to 0.5" depth. | Lathe | Use center drill first to guide
6 | Tap | Tap (8) holes for 3-48 UNC - 2B threads | Lathe
7 | Hand Debur | Remove sharp edges | Hand Tool
8
9

Sheet: Short Battery Side Wall (D)
Step | Operation | Description | Equipment | Notes
1 | Raw Stock | Start with 12" x 24" x 0.25" UHMW plastic sheet | -
2 | Mark Dimensions | Measure and mark the cut lines for 9" x 2.5" on the sheet. | CNC Machine | Use the CNC for marking .DXF file will be provided
3 | CNC Cut | Use the CNC to trim the rough cut to exact 9" x 2.5" x 0.25" dimensions. | CNC Machine
4 | CNC Cut | Use the CNC to cut rectangular cut to exact 2.5" x 1.25 x Through dimensions on bottom left corner | CNC Machine | Rectangle Cut for battery access
5 | Center Drill | Mark the 4 hole locations as per drawing specifications | Lathe (Center Drill) | Verify Hole Locations in the drawing
6 | Drill | Drill 4 Holes, Drill (2) holes using a #47 drill (Ø 0.079") to 0.5" depth. | Lathe | Use center drill first to guide
7 | Tap | Tap (8) holes for 3-48 UNC - 2B threads | Lathe
8 | Hand Debur | Remove sharp edges | Hand Tool
9
10

Sheet: Foot Pedals (D)
Step | Operation | Description | Equipment | Notes
1 | Raw Stock | UHMW Plastic, .25" Thick | CNC
2 | Cut Grooves | groove depth 0.025" | CNC | .DXF file provided
3 | Debur | Remove Facing Bur | Pedestal Grinder | >100 Grit
4 | Hand Debur | Remove all sharp edges | Hand tool

Sheet: Base Lid (D)
Step | Operation | Description | Equipment | Notes
1 | Raw Stock | Plexiglass, 0.125 Thick | Laser Cut | .DXF File will be provided
2 | Hand Debur | Remove all sharp edges | Hand tool
3
4
5
6
7
8
9

Sheet: Gear Axle
Step | Operation | Description | Equipment | Notes
1 | Raw Stock | 3.25 x Ø 0.5 | Bandsaw | 200 FPM
2 | Face ends | Face both ends | Lathe | S = 60, F= Hand (locations in Drawing)
3 | Center Drill | #0 Center Drill 0.03 Deep | Lathe | On the end
4 | Drill | 5/16 Drill 0.8 Deep | Lathe | S = 100, F = Hand
5 | Ream | Ø 0.316,0 .8 Deep | Lathe | S = 130, F = Hand | this is .0011 larger than shaft
6 | Center Drill | #0 Center Drill 0.03 Deep | Mill | On the top
7 | Drill | #7 Drill (0.201) THRU | Mill | S = 100, F = Hand
8 | Tap | 1/4-20 UNC - 2B TAP THRU | Mill | Hand
9 | Endmill | 1/16 endmill | Mill | Keyway
10 | Hand Debur | Remove all sharp edges | Hand tool

Sheet: Motor Mount (D)
Step | Operation | Description | Equipment | Notes
1 | Raw Stock | Stainless Steel Sheet Metal, 0.25 Thick | Laser Cut | .DXF will be provided
2 | Mill | Ø 0.16 X 0.25 Deep (4 times) | Mill | S = 60, F= Hand (locations in Drawing)
3 | Tap | M3 Thread Size | Hand Tap | ensure to lube
4 | Debur | Remove Facing Bur | Pedestal Grinder | >100 Grit
5 | Hand Debur | Remove all sharp edges | Hand tool

Sheet: Bearing Mount (D)
Step | Operation | Description | Equipment | Notes
1 | Raw Stock | Stainless Steel Sheet Metal, 0.25 Thick | Laser Cut | .DXF File will be provided
2 | Debur | Remove Facing Bur | Pedestal Grinder | >100 Grit
3 | Hand Debur | Remove all sharp edges | Hand tool

Sheet: Testing Probe Casing (D)
Step | Operation | Description | Equipment | Notes
1 | Raw Stock | PLA Filament (40% Infill Density) | 3D Printer (Lulzbot Taz 6) | .STL file will be provided: Resolution: 0.2mm - Standard Quality, Traingular Infill Patterns, 0.8mm Shell Thickness, Color: Black
2 | Top Casing Printing | House OLED Display, Arduino Port Holes | 3D Printer (Lulzbot Taz 6) | Layer Height: 0.25mm, Prinitive Temperature: 200 Deg C
3 | Bottom Casing Printing | Holds Battery, SD Card Port, Charging/USB Ports, Slit for Battery Life Measurement | 3D Printer (Lulzbot Taz 6) | Layer Height: 0.25mm, Prinitive Temperature: 200 Deg C
4 | Sanding | Smooth Surfaces | Sandpaper of ~100 Grit | >100 Grit
5 | Deburring Holes | Remove all sharp edges, x2 Ø 0.60 Curve Diameter, 1.2" Hole Length (Top & Bottom) | Hand Debur - Hand Tap
6 | Casing Assembly | Join top and bottom casing | Plastic Welding Gun / Hot Glue Gun
