lokichubs/TerraProbe/Documentation/FDR/Economic_Analysis_FDR.xlsx

Sheet: Financials
TerraProbe Product Cost
 | Component #1 - ESP 32 Module/Arduino Uno |  | Component #2 - NPK Soil Sensor |  | Component #3 - Soil Moisture Sensor |  | Component #4 - Motors |  | Component #6 - SD Card Module |  |  | Component #6 - SD Card Module
Material List
ESP 32 Module/Arduino Uno | Descripton | Main Controller Module | Descripton | Nitrogen, Phosphorous, Pottasium Sensor | Descripton | Nitrogen, Phosphorous, Pottasium Sensor | Descripton | DC 24V Electric Gear Motor 45W, Qty 2 | Descripton | Transfer Data for SD Card Module |  | Descripton | Transfer Data for SD Card Module
NPK Soil Sensor | Vendor | Amazon | Vendor | Amazon | Vendor | Amazon | Vendor | Walmart | Vendor | Amazon |  | Vendor | Amazon
Soil Moisture Sensor | Retail Cost | $15.99 | Retail Cost | $49.52 | Retail Cost | $8.68 | Retail Cost | $97.44 | Retail Cost | $15.00 |  | Retail Cost | $15.00
Soil Tempreature | Units / yr | 5000 | Units / yr | 5000 | Units / yr | 5000 | Units / yr | 5000 | Units / yr | 5000 |  | Units / yr | 5000
20V Dual Battry | Volumized % of Retail | 80.00% | Volumized % of Retail | 80.00% | Volumized % of Retail | 80.00% | Volumized % of Retail | 80.00% | Volumized % of Retail | 80.00% |  | Volumized % of Retail | 80.00%
12V/5V Dual Battery
High Torque Motors | Part Cost | $12.79 | Part Cost | $39.62 | Part Cost | $6.94 | Part Cost | $77.95 | Part Cost | $12.00 |  | Part Cost | $12.00
Electrical Buttons
Display Module | Overhead | 8.50% | Overhead | 8.50% | Overhead | 8.50% | Overhead | 8.50% | Overhead | 8.50% |  | Overhead | 8.50%
Wires
Soldering Iron | Component Cost | $13.88 | Component Cost | $42.98 | Component Cost | $7.53 | Component Cost | $84.58 | Component Cost | $13.02 |  | Component Cost | $13.02
Waterproofing Plastics
Rack Gears
Pinion Gears | Component #7 - Batteries |  | Component #8 - Electrical Hardware |  | Component #9 - Shaft |  | Component #10 - Rack |  | Component #11 - Barrel Plug |  |  | Component #11 - Bearings
Steel Cyclinder
Foot Stands | Descripton | 24V Lithium ion Battery PB240A1, Rechargeable 1 5V Battery | Descripton | Buttons, Display Module, Wires | Descripton | Shaft for Gear Motor System | Descripton | Metal Gear Rack - 20 Degree Pressure Angle, 16 Pitch, 4 ft Length | Descripton | Male Female Power Plug Connector |  | Descripton | Ball Bearing, 0.5" Diameter
One Way Valve | Vendor | Amazon | Vendor | Amazon | Vendor | McMaster | Vendor | McMasterCarr | Vendor | Amazon |  | Vendor | McMasterCarr
PLA Plastic (High Quality Roll) | Retail Cost | $93.97 | Retail Cost | $23.23 | Retail Cost | $25.99 | Retail Cost | $70.11 | Retail Cost | $0.95 |  | Retail Cost | $32.16
Machining Cost (External) | Units / yr | 5000 | Units / yr | 5000 | Units / yr | 5000 | Units / yr | 10000 | Units / yr | 5000 |  | Units / yr | 5000
Steels or Metal Scraps | Volumized % of Retail | 80.00% | Volumized % of Retail | 80.00% | Volumized % of Retail | 80.00% | Volumized % of Retail | 80.00% | Volumized % of Retail | 80.00% |  | Volumized % of Retail | 80.00%
TerraProbe Product Cost | Part Cost | $75.18 | Part Cost | $18.58 | Part Cost | $20.79 | Part Cost | $56.09 | Part Cost | $0.76 |  | Part Cost | $25.73
$862.77
 | Overhead | 8.50% | Overhead | 8.50% | Overhead | 8.50% | Overhead | 8.50% | Overhead | 8.50% |  | Overhead | 8.50%
Margin
25.00% | Component Cost | $81.57 | Component Cost | $20.16 | Component Cost | $22.56 | Component Cost | $60.86 | Component Cost | $0.82 |  | Component Cost | $27.91
Sales Price
$1078.46 | Component #12 - Round Tubing |  | Component #13 - Sheet Metal |  | Component #14 - Key |  | Component #15 - Pinion |  | Component #16 - Transceiver |  |  | Component #11 - Plexiglass
10-Year Sales Volume | Dimensions | 2 Hollow Tubes (1 3.125" OD and 1 3.5" OD) | Volume | 140 | Descripton | 12 Teeth, 1.17" Carbon Steel Gear, Qty 4 | Descripton | Metal Gear - 20 Degree Pressure Angle, Round Bore with Set Screw, 16 Pitch, 16 Teeth, Qty 2 | Descripton | Transceiver Module for Arduino Raspberry Pi |  | Descripton | 1/8" thick plexiglas, 5" x 7"
40000 | Vendor | McMasterCarr | Material | Alloy Steel | Vendor | McMasterCarr | Vendor | McMasterCarr | Vendor | Amazon |  | Vendor | Amazon
 | Material | $120.00 | Density [kg/in^3] | 0.13 | Retail Cost | $15.16 | Retail Cost | $90.42 | Retail Cost | $1.00 |  | Retail Cost | $5.99
Annual Revenue | Area Per Part [Feet] | 2 | Weight [kg] | 25.00 | Units / yr | 5000 | Units / yr | 10000 | Units / yr | 5000 |  | Units / yr | 5000
$43138370.50 | Cost Per Feet | $1.20 | Cost / kg | $4.41 | Volumized % of Retail | 90.00% | Volumized % of Retail | 90.00% | Volumized % of Retail | 80.00% |  | Volumized % of Retail | 80.00%
 | Material Cost | $2.40 | Material Cost | $110.25
Annual Cost |  |  |  |  | Part Cost | $13.64 | Part Cost | $81.38 | Part Cost | $0.80 |  | Part Cost | $4.79
$34510696.40 | Machining/Cutting Hours | 1 | Machining/Cutting Hours | 0.25
 | Labor Rate | $60.00 | Labor Rate | $60.00 | Overhead | 8.50% | Overhead | 8.50% | Overhead | 8.50% |  | Overhead | 8.50%
Annual Gross Profit | Labor Cost | $60.00 | Labor Cost | $15.00
$8627674.10 |  |  |  |  | Component Cost | $14.80 | Component Cost | $88.30 | Component Cost | $0.87 |  | Component Cost | $5.20
 | Material + Labor Cost | $62.40 | Material + Labor Cost | $125.25
 | Overhead | 35.00% | Overhead | 35.00%
 |  |  |  |  |  |  |  |  | Assembly Time [hrs]
 | Component Cost | $84.24 | Component Cost | $169.09
 |  |  |  |  |  |  |  |  | Sub-Assembly 1 - Inner Tube | 0.25 | hr
Consumable Inner Tubes Cost |  |  |  |  |  |  |  |  | Sub-Assembly 2 - Guidance System | 0.75 | hr
$84.24 |  |  |  |  |  |  |  |  | Sub-Assembly 3 - Sensor Probe | 0.25 | hr
 |  |  |  |  |  |  |  |  | Final Assembly | 0.125 | hr
Consumable Inner Tubes Margin |  |  |  |  |  |  |  |  | Total Assembly Time | 1.375 | hr
50.00%
 |  |  |  |  |  |  |  |  | Labor Rate | $60.00 | /hr
Consumable Inner Tubes Sales Price
$126.36 |  |  |  |  |  |  |  |  | Overhead | 35.00%
 |  |  |  |  |  |  |  |  | Component Cost | $111.38
Analytics Price (Per Month Per User)
$12.00
Analytics Cost (Maintenance)
$100000.00

Sheet: Projections
Years | 1 | 2 | 3 | 4 | 5 | 6 | 7 | 8 | 9 | 10
TerraProbe Units Sold | 0 | 5000 | 10000 | 15000 | 20000 | 25000 | 30000 | 35000 | 40000 | 40000
TerraProbe Cost | $10000000.00 | $4313837.05 | $8627674.10 | $12941511.15 | $17255348.20 | $21569185.25 | $25883022.30 | $30196859.35 | $34510696.40 | $34510696.40
TerraProbe Revenue | $0.00 | $5392296.31 | $10784592.62 | $16176888.94 | $21569185.25 | $26961481.56 | $32353777.88 | $37746074.19 | $43138370.50 | $43138370.50
Consumable Inner Tubes Units | 0 | 0 | 5000 | 10000 | 15000 | 20000 | 25000 | 27000 | 29000 | 30000
Consumable Inner Tubes Cost | $0.00 | $0.00 | $421200.00 | $842400.00 | $1263600.00 | $1684800.00 | $2106000.00 | $2274480.00 | $2442960.00 | $2527200.00
Consumable Inner Tubes Revenue | $0.00 | $0.00 | $631800.00 | $1263600.00 | $1895400.00 | $2527200.00 | $3159000.00 | $3411720.00 | $3664440.00 | $3790800.00
Analytics Services Cost | $100000.00 | $100000.00 | $100000.00 | $100000.00 | $100000.00 | $100000.00 | $100000.00 | $100000.00 | $100000.00 | $100000.00
Analytics Services Revenue | $0.00 | $600000.00 | $1200000.00 | $1800000.00 | $2400000.00 | $3000000.00 | $3600000.00 | $4200000.00 | $4800000.00 | $4800000.00
Total Cost | $10100000.00 | $4413837.05 | $9148874.10 | $13883911.15 | $18618948.20 | $23353985.25 | $28089022.30 | $32571339.35 | $37053656.40 | $37137896.40
Total Revenue | $0.00 | $5992296.31 | $12616392.62 | $19240488.94 | $25864585.25 | $32488681.56 | $39112777.88 | $45357794.19 | $51602810.50 | $51729170.50
Profit | -$10100000.00 | $1578459.26 | $3467518.53 | $5356577.79 | $7245637.05 | $9134696.31 | $11023755.57 | $12786454.84 | $14549154.10 | $14591274.10
ROI |  | 11.03% | 18.61% | 23.35% | 26.58% | 28.94% | 30.72% | 31.81% | 32.69% | 32.78%
Assumptions
First Year - No Sale, Only Production
First Sale Year sell 50000 units
Second Sale Year onwards 380000 units
R&D Costs
