lokichubs/TerraProbe/Documentation/PDR/Economic_Analysis.xlsx

Sheet: Financials
TerraProbe Product Cost
 | Component #1 - ESP 32 Module/Arduino Uno |  | Component #2 - NPK Soil Sensor |  | Component #3 - Soil Moisture Sensor |  | Component #4 - Motors
Material List
ESP 32 Module/Arduino Uno | Descripton | Main Controller Module | Descripton | Nitrogen, Phosphorous, Pottasium Sensor | Descripton | Nitrogen, Phosphorous, Pottasium Sensor | Descripton | DC 24V Electric Gear Motor 45W, Qty 2
NPK Soil Sensor | Vendor | Amazon | Vendor | Amazon | Vendor | Amazon | Vendor | Walmart
Soil Moisture Sensor | Retail Cost | $15.99 | Retail Cost | $47.12 | Retail Cost | $8.68 | Retail Cost | $98.00
Soil Tempreature | Units / yr | 5000 | Units / yr | 5000 | Units / yr | 5000 | Units / yr | 5000
20V Dual Battry | Volumized % of Retail | 80.00% | Volumized % of Retail | 80.00% | Volumized % of Retail | 80.00% | Volumized % of Retail | 80.00%
12V/5V Dual Battery
High Torque Motors | Part Cost | $12.79 | Part Cost | $37.70 | Part Cost | $6.94 | Part Cost | $78.40
Electrical Buttons
Display Module | Overhead | 8.50% | Overhead | 8.50% | Overhead | 8.50% | Overhead | 8.50%
Wires
Soldering Iron | Component Cost | $13.88 | Component Cost | $40.90 | Component Cost | $7.53 | Component Cost | $85.06
Waterproofing Plastics
Rack Gears
Pinion Gears | Component #5 - Batteries |  | Component #6 - Electrical Hardware |  | Component #7 - Temperature Sensor |  | Component #8 - Rack |  | Assembly Time [hrs]
Steel Cyclinder
Foot Stands | Descripton | 1 20V Dual Battery 1 12V Battery | Descripton | Buttons, Display Module, Wires | Descripton | Temperature Sensor Chip | Descripton | Gear Racks, 1.125" Gear Pitch, Qty 2 | Sub-Assembly 1 - Inner Tube | 0.25 | hr
One Way Valve | Vendor | Amazon | Vendor | Amazon | Vendor | Amazon | Vendor | McMasterCarr | Sub-Assembly 2 - Guidance System | 0.75 | hr
PLA Plastic (High Quality Roll) | Retail Cost | $61.97 | Retail Cost | $23.23 | Retail Cost | $9.99 | Retail Cost | $127.34 | Sub-Assembly 3 - Sensor Probe | 0.25 | hr
Machining Cost (External) | Units / yr | 5000 | Units / yr | 5000 | Units / yr | 5000 | Units / yr | 5000 | Final Assembly | 0.125 | hr
Steels or Metal Scraps | Volumized % of Retail | 80.00% | Volumized % of Retail | 80.00% | Volumized % of Retail | 80.00% | Volumized % of Retail | 80.00% | Total Assembly Time | 1.375 | hr
Total Product Cost | Part Cost | $49.58 | Part Cost | $18.58 | Part Cost | $7.99 | Part Cost | $101.87 | Labor Rate | $60.00 | /hr
$905.86
 | Overhead | 8.50% | Overhead | 8.50% | Overhead | 8.50% | Overhead | 8.50% | Overhead | 35.00%
Margin
65.00% | Component Cost | $53.79 | Component Cost | $20.16 | Component Cost | $8.67 | Component Cost | $110.53 | Component Cost | $111.38
Sales Price
$1494.67 | Component #9 - Waterproofing Plastics |  | Component #10 - Steel |  | Component #11 - Driver Gear |  | Component #12 - Pinion
Sales Volume | Dimensions | 12" x 100' (30 Mil Thickness) | Volume | 140 | Descripton | 12 Teeth, 1.17" Carbon Steel Gear, Qty 4 | Descripton | Metal Gear - 20 Degree Pressure Angle, Round Bore with Set Screw, 24 Pitch, 48 Teeth, Qty 2
380000.00 | Vendor | Mainline Materials | Material | Alloy Steel | Vendor | McMasterCarr | Vendor | Amazon
 | Material | $202.26 | Density [kg/in^3] | 0.13 | Retail Cost | $123.32 | Retail Cost | $79.86
Annual Revenue | Area Per Part [Feet] | 2 | Weight [kg] | 25.00 | Units / yr | 1000 | Units / yr | 1000
$567973097.67 | Cost Per Feet | $2.02 | Cost / kg | $4.41 | Volumized % of Retail | 90.00% | Volumized % of Retail | 90.00%
 | Material Cost | $4.05 | Material Cost | $110.25
Annual Cost |  |  |  |  | Part Cost | $110.99 | Part Cost | $71.87
$344226119.80 | Machining/Cutting Hours | 1 | Machining/Cutting Hours | 0.25
 | Labor Rate | $60.00 | Labor Rate | $60.00 | Overhead | 8.50% | Overhead | 8.50%
Annual Gross Profit | Labor Cost | $60.00 | Labor Cost | $15.00
$223746977.87 |  |  |  |  | Component Cost | $120.42 | Component Cost | $77.98
 | Material + Labor Cost | $64.05 | Material + Labor Cost | $125.25
 | Overhead | 35.00% | Overhead | 35.00%
 | Component Cost | $86.46 | Component Cost | $169.09

Sheet: Projections
Years | 1 | 2 | 3 | 4 | 5 | 6 | 7 | 8 | 9 | 10
Units Sold | 0 | 5000 | 10000 | 25000 | 50000 | 100000 | 200000 | 380000 | 380000 | 380000
Cost | $10100000.00 | $4629150.00 | $9158300.00 | $22745750.00 | $45391500.00 | $90683000.00 | $181266000.00 | $344315400.00 | $344315400.00 | $344315400.00
Revenue | $0.00 | $7500000.00 | $15000000.00 | $37500000.00 | $75000000.00 | $150000000.00 | $300000000.00 | $570000000.00 | $570000000.00 | $570000000.00
Profit | -$10100000.00 | $2870850.00 | $5841700.00 | $14754250.00 | $29608500.00 | $59317000.00 | $118734000.00 | $225684600.00 | $225684600.00 | $225684600.00
ROI |  | 19.49% | 30.33% | 44.92% | 53.36% | 58.86% | 62.05% | 63.68% | 63.68% | 63.68%
Assumptions
First Year - No Sale, Only Production
First Sale Year sell 50000 units
Second Sale Year onwards 380000 units
R&D Costs
