lokichubs/TerraProbe/Dashboard/TEST.TXT

|    1    |        53.1        |        255        |         20          |         28        |        2 in
|    2    |        51.8        |        57        |         20          |         28        |        2 in
|    3    |        51.5        |        55        |         19          |         27        |        2 in
|    4    |        51.8        |        54        |         19          |         27        |        2 in
|    5    |        51.7        |        54        |         19          |         27        |        2 in
|    6    |        52.4        |        53        |         19          |         26        |        2 in
|    7    |        51.2        |        53        |         18          |         26        |        2 in
|    8    |        51.8        |        52        |         18          |         26        |        2 in
|    9    |        51.2        |        52        |         18          |         26        |        2 in
|    10    |        51.5        |        52        |         18          |         26        |        2 in
|    1    |        56.1        |        51        |         36          |         50        |        4 in
|    2    |        56.1        |        96        |         34          |         48        |        4 in
|    3    |        56.7        |        89        |         32          |         44        |        4 in
|    4    |        55.9        |        81        |         29          |         40        |        4 in
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
|    9    |        0.0        |        0        |         0          |         0        |        12 in
|    10    |        0.0        |        0        |         0          |         0        |        12 in
