lokichubs/TerraProbe/Documentation/FDR/463_S25_Poster_080_Shin_D2E-Down to Earth.pdf

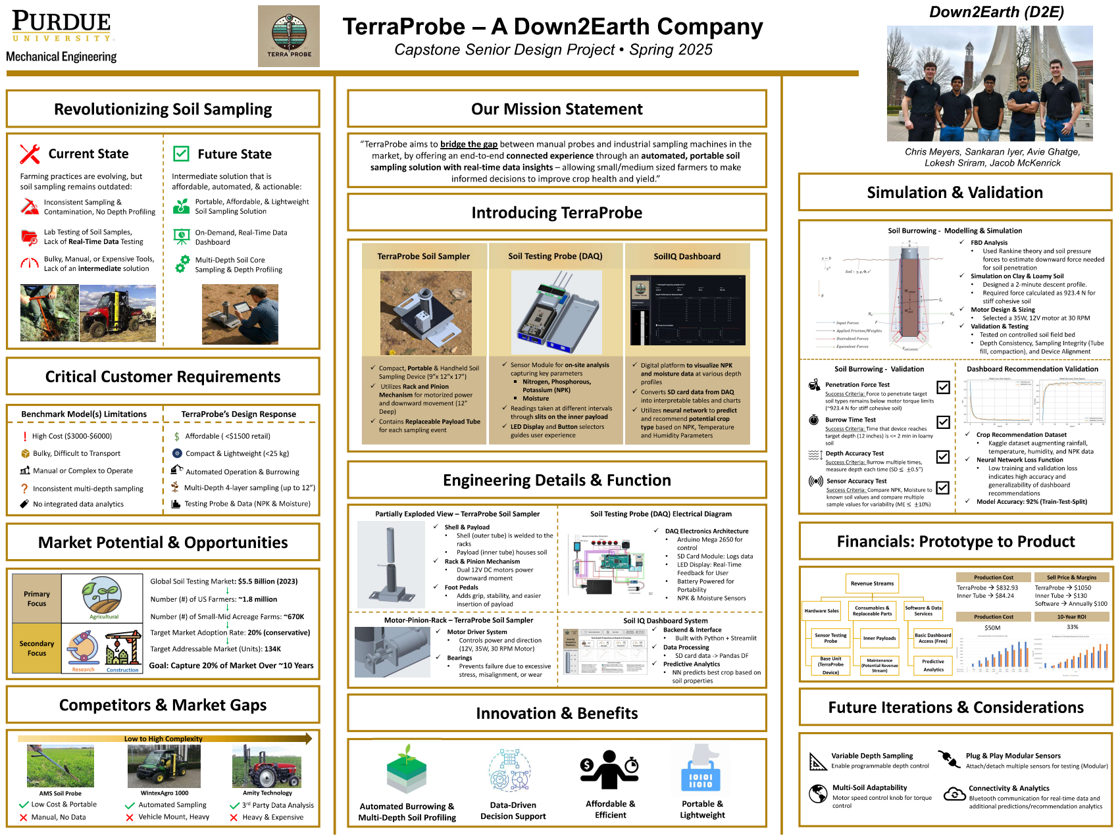
[picture p103: page 1]
