lokichubs/TerraProbe/Documentation/PDR/Concept Designs.pdf

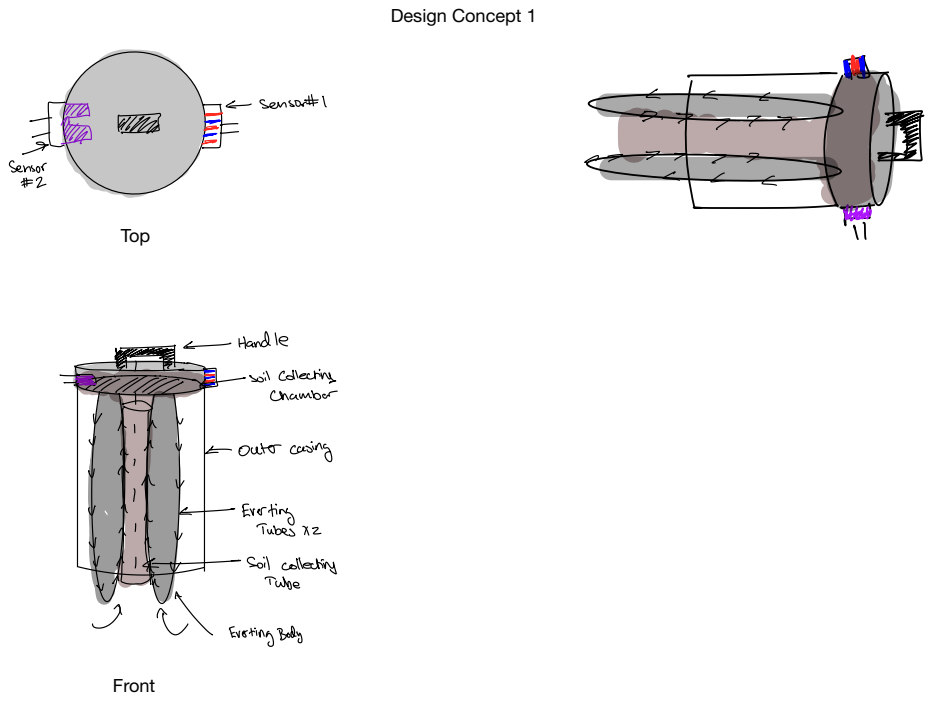
[picture p104: page 1]
Front; Top; Design Concept 1

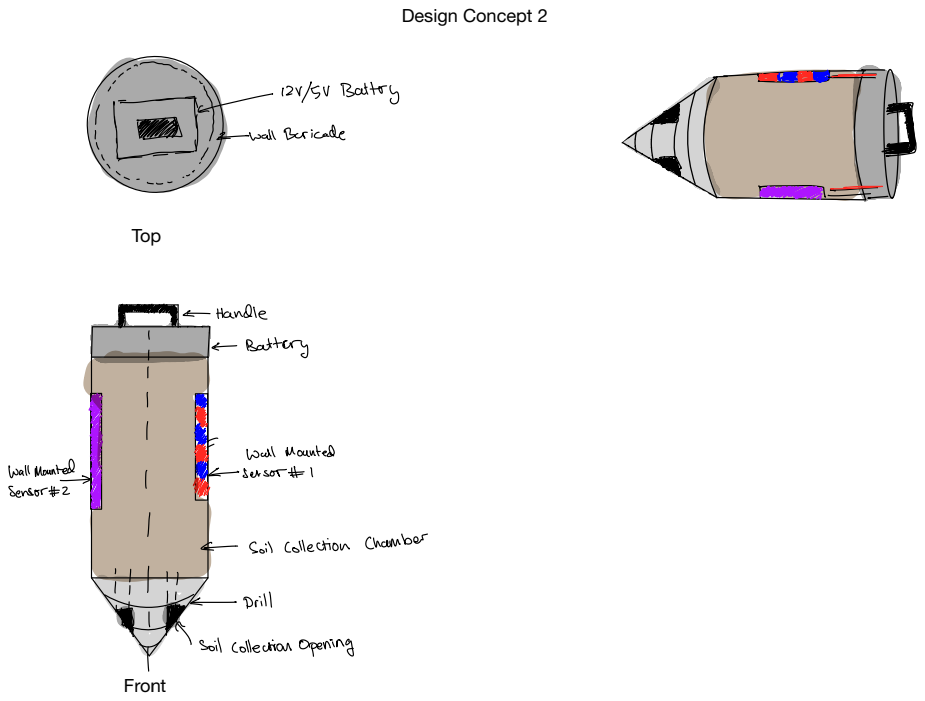
[picture p105: page 2]
Front; Top

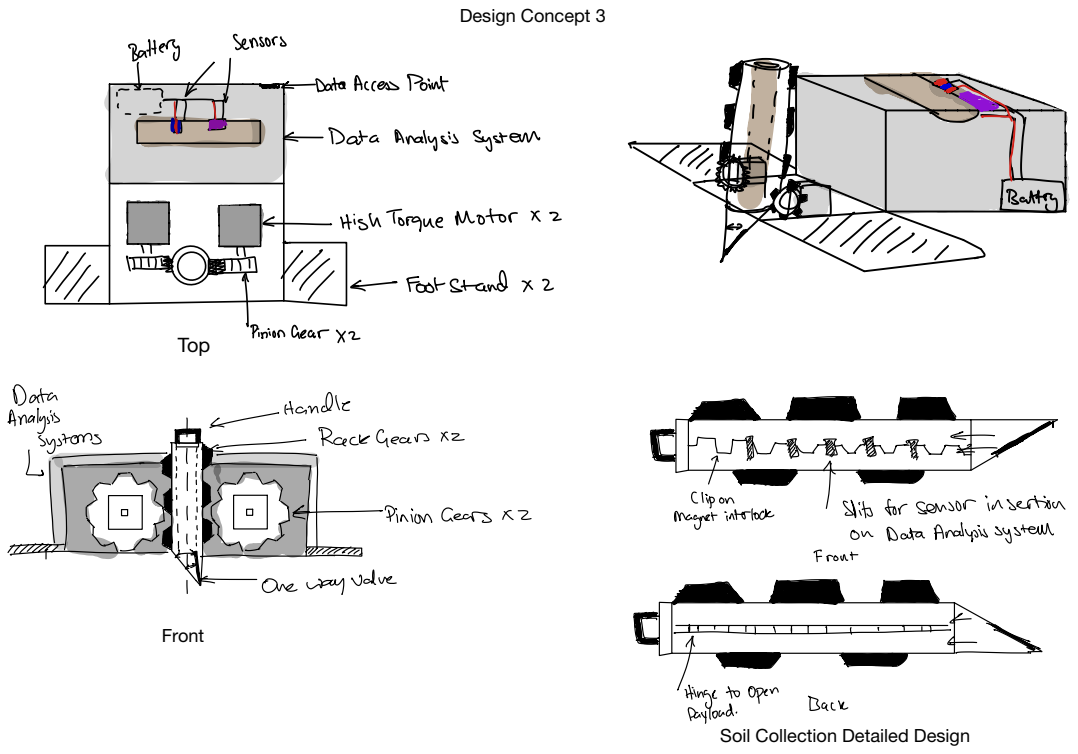
[picture p106: page 3]
Front; Top; s III; III

Soil Collection Detailed Design
