lokichubs/TerraProbe/(commit log)

2025-01-30 Added Torque Calculation
2025-02-04 Started working on gear faliure mechanics
2025-02-04 Added folder for gear train
2025-02-06 Added Gear Faliure Mechanics
2025-02-07 Finished up gear faliure analysis
2025-02-11 Converted Gear Mesh to Pinion-Rack
2025-02-11 Changed material properties
2025-02-11 Changed Material to Grade-1 Hardened and Carburized
2025-02-18 added other gear mesh
2025-02-19 Changed motor parameters
2025-02-19 Changed gear-rack mesh to grade 3 gears
2025-02-20 Added links to gear and rack parameters
2025-02-21 Added Shaft, Bearing, and Key design
2025-02-21 fixed pitting resistance factor on rack mesh
2025-02-23 Changed to input shaft
2025-02-24 Added Shaft,Bearing, and Key Design file
2025-02-27 Adjusted shaft to 3 inches long instead of 10 inch shaft
2025-02-27 added comments to remove 2nd bearing
2025-02-28 Added PDR documentation
    [Budget_BOM - ME463.xlsx, Decision_Matrix.xlsx, Economic_Analysis.xlsx, Project Charter.xlsx, Project_Schedule.xlsx, Risk Register TerraProbe - ME463.xlsx]
2025-02-28 Added Readme file
    [Budget_BOM - ME463.xlsx, Decision_Matrix.xlsx, Economic_Analysis.xlsx, Project Charter.xlsx, Project_Schedule.xlsx, Risk Register TerraProbe - ME463.xlsx]
2025-05-07 Added dashboard code
    [Crop_recommendation.csv]
2025-05-17 Added CDR documentation
    [Economic_Analysis_CDR.xlsx, FMEA_CDR.xlsx, Project_Charter_v2.xlsx, Project_Schedule_CDR.xlsx, Risk_Register_CDR.xlsx]
2025-05-22 Added FDR documentation
    [Budget_BOM - ME463.xlsx, Economic_Analysis_FDR.xlsx, FMEA_FDR.xlsx, Operation_Sheets.xlsx, Project_Charter_v2.xlsx, Project_Schedule_FDR.xlsx, Risk_Register_FDR.xlsx, Soil_Burrowed.xlsx]
2025-05-22 Added DAW and Motor Control
    [Crop_recommendation.csv]
